NadjB/Hard_Bifrost/Docs/AD9851 DDS DAC Waveform Synthesizer/Carte de développement de générateur de Signal DDS AD9851.jpg

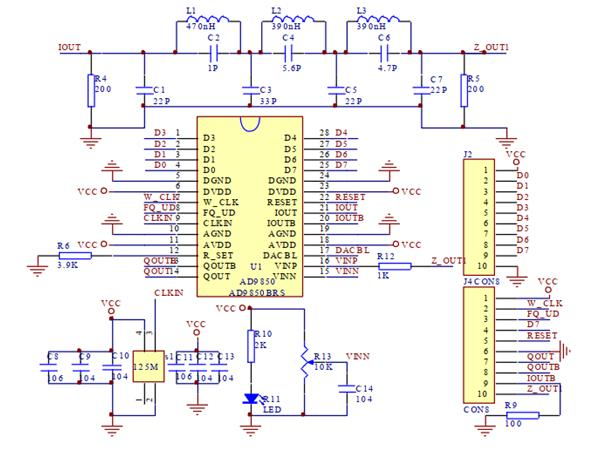
Docs/AD9851 DDS DAC Waveform Synthesizer/Carte de développement de générateur de Signal DDS AD9851.jpg
