NadjB/Hard_Bifrost/Docs/AD9851 DDS DAC Waveform Synthesizer/JOnYrMHFzqMlmSxvhkgJ.jpg

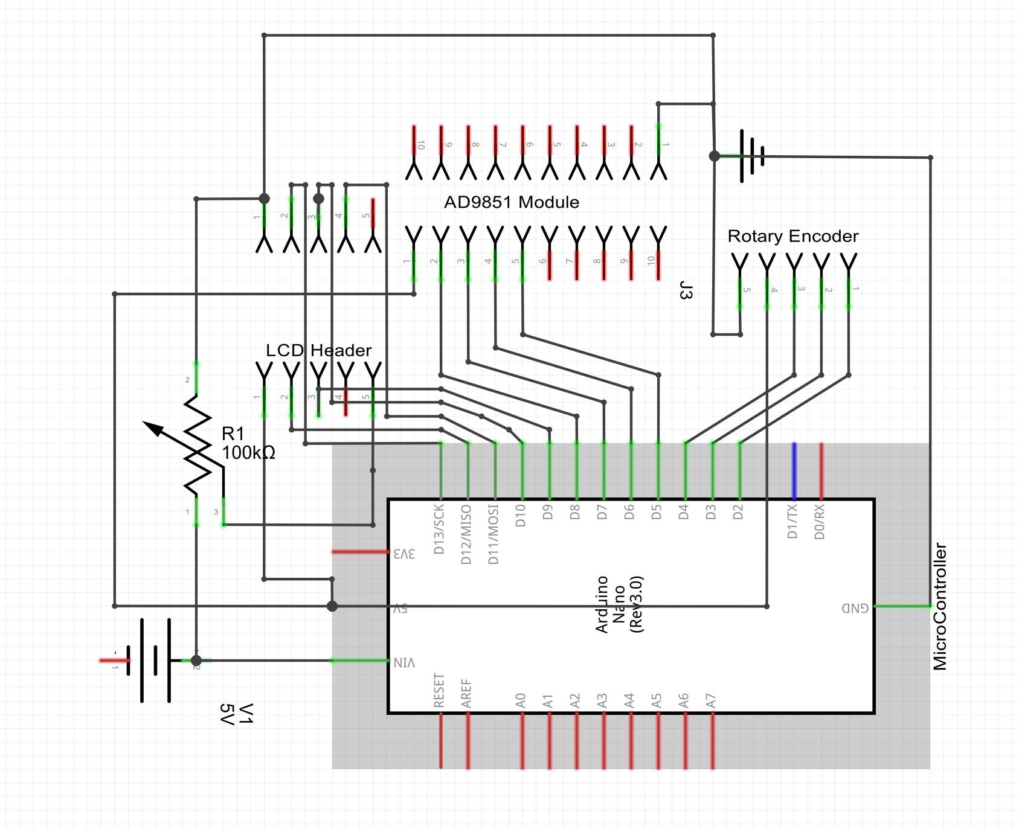
Docs/AD9851 DDS DAC Waveform Synthesizer/JOnYrMHFzqMlmSxvhkgJ.jpg
