NadjB/Hard_Bifrost/Bifrost.kicad_pcb

## KiCad design Bifrost.kicad_pcb (2023-07-12)

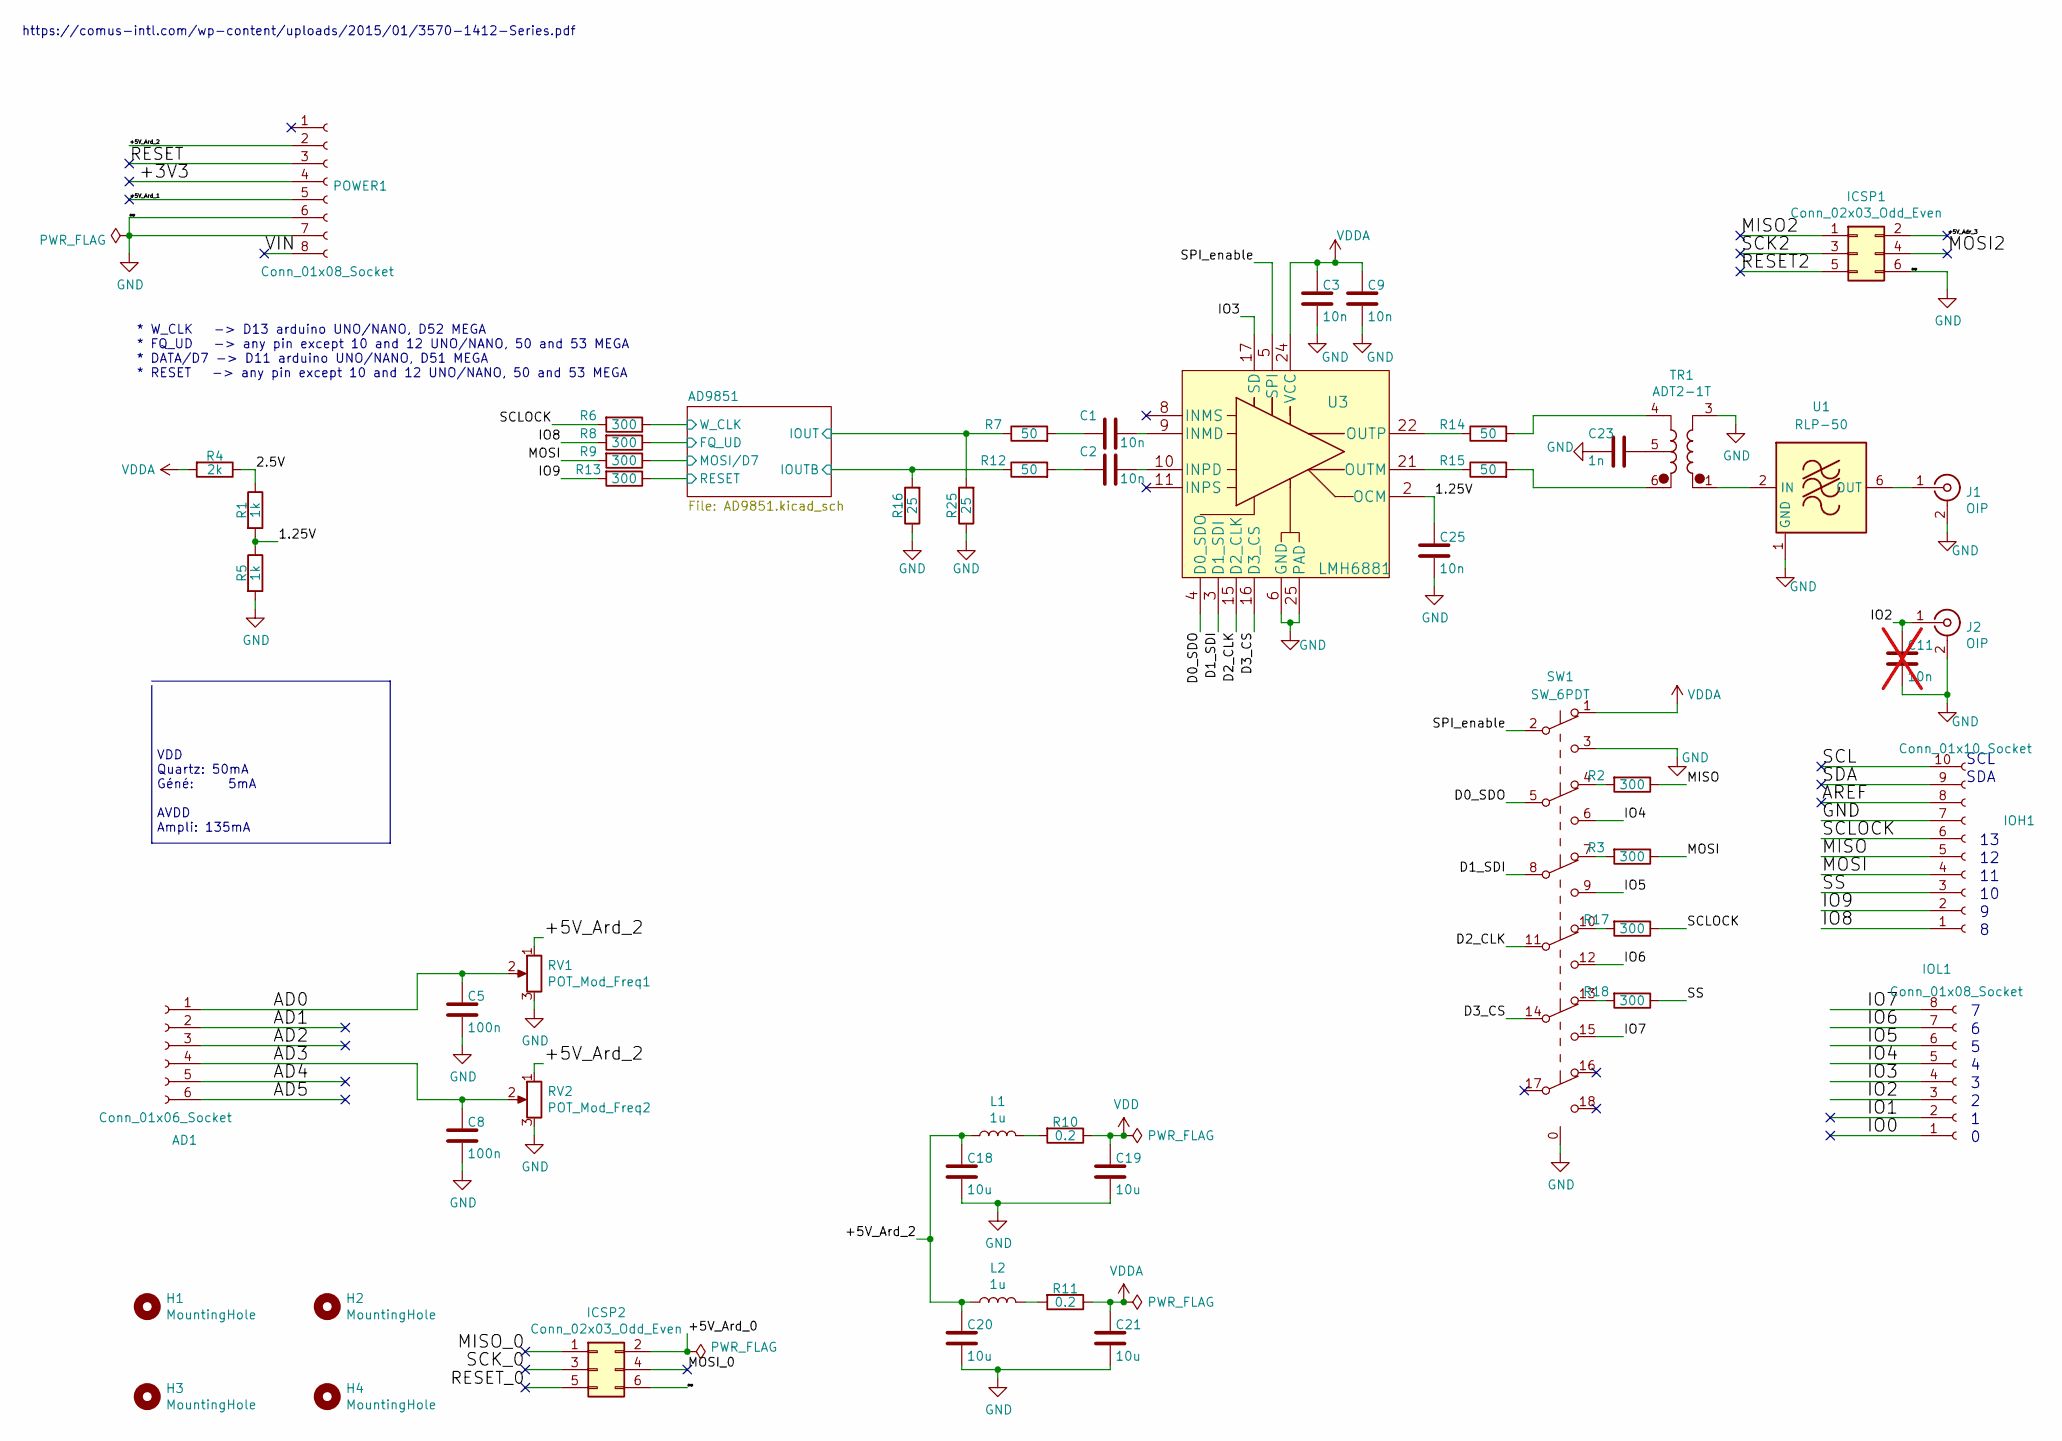
[picture p3: schematic Bifrost.kicad_sch]

Parts:
AD1: Conn_01x06_Socket; PinHeader_1x06_P2.54mm_Vertical
C1, C2, C3, C9, C25: 10n; C_0603_1608Metric_Pad1.08x0.95mm_HandSolder
C5, C8: 100n; C_0603_1608Metric_Pad1.08x0.95mm_HandSolder
C11: 10n; C_0603_1608Metric_Pad1.08x0.95mm_HandSolder; not fitted
C18, C19, C20, C21: 10u; C_1206_3216Metric_Pad1.33x1.80mm_HandSolder
C23: 1n; C_0603_1608Metric_Pad1.08x0.95mm_HandSolder
H1, H2, H3, H4: MountingHole; MountingHole_3mm
ICSP1, ICSP2: Conn_02x03_Odd_Even; PinSocket_2x03_P2.54mm_Vertical
IOH1: Conn_01x10_Socket; PinHeader_1x10_P2.54mm_Vertical
IOL1: Conn_01x08_Socket; PinHeader_1x08_P2.54mm_Vertical
J1, J2: OIP; SMA_Molex_73251-1153_EdgeMount_Horizontal
L1, L2: 1u; L_0603_1608Metric_Pad1.05x0.95mm_HandSolder
POWER1: Conn_01x08_Socket; PinHeader_1x08_P2.54mm_Vertical
R1, R5: 1k; R_0603_1608Metric_Pad0.98x0.95mm_HandSolder
R2, R3, R6, R8, R9, R13, R17, R18: 300; R_0603_1608Metric_Pad0.98x0.95mm_HandSolder
R4: 2k; R_0603_1608Metric_Pad0.98x0.95mm_HandSolder
R7, R12, R14, R15: 50; R_0603_1608Metric_Pad0.98x0.95mm_HandSolder
R10, R11: 0.2; R_0603_1608Metric_Pad0.98x0.95mm_HandSolder
R16, R25: 25; R_0603_1608Metric_Pad0.98x0.95mm_HandSolder
RV1: POT_Mod_Freq1; Potentiometer_Bourns_3266Y_Vertical
RV2: POT_Mod_Freq2; Potentiometer_Bourns_3266Y_Vertical
SW1: SW_6PDT; SW_EG6201
TR1: ADT2-1T; Mini-Circuits_CD542_H2.84mm
U1: RLP-50; Mini-Circuits_GP1212_LandPatternPL-176
U3: LMH6881; WQFN-24-1EP_4x4mm_P0.5mm_EP2.45x2.45mm_ThermalVias

Connections:
/1.25V: C25.2, R1.2, R5.1, U3.2 (OCM)
/2.5V: R1.1, R4.1
/+3V3: POWER1.4
/+5V_Adr_3: ICSP1.2
/+5V_Ard_0: ICSP2.2
/+5V_Ard_1: POWER1.5
/+5V_Ard_2: C18.2, C20.2, L1.1, L2.1, POWER1.2, RV1.1, RV2.1
/AD0: AD1.1, C5.2, RV1.2
/AD1: AD1.2
/AD2: AD1.3
/AD3: AD1.4, C8.2, RV2.2
/AD4: AD1.5
/AD5: AD1.6
/AD9851/FQ_UD: R8.1; also elsewhere on the board
/AD9851/IOUT: R7.1, R25.2; also elsewhere on the board
/AD9851/IOUTB: R12.1, R16.2; also elsewhere on the board
/AD9851/MOSI/D7: R9.1; also elsewhere on the board
/AD9851/RESET: R13.1; also elsewhere on the board
/AD9851/W_CLK: R6.1; also elsewhere on the board
/AREF: IOH1.8
/D0_SDO: SW1.5 (B), U3.4 (D0_SDO)
/D1_SDI: SW1.8 (B), U3.3 (D1_SDI)
/D2_CLK: SW1.11 (B), U3.15 (D2_CLK)
/D3_CS: SW1.14 (B), U3.16 (D3_CS)
/IO0: IOL1.1
/IO1: IOL1.2
/IO2: C11.2, IOL1.3, J2.1 (In)
/IO3: IOL1.4, U3.17 (SD)
/IO4: IOL1.5, SW1.6 (C)
/IO5: IOL1.6, SW1.9 (C)
/IO6: IOL1.7, SW1.12 (C)
/IO7: IOL1.8, SW1.15 (C)
/IO8: IOH1.1, R8.2
/IO9: IOH1.2, R13.2
/MISO: IOH1.5, R2.1
/MISO2: ICSP1.1
/MISO_0: ICSP2.1
/MOSI: IOH1.4, R3.1, R9.2
/MOSI2: ICSP1.4
/MOSI_0: ICSP2.4
/RESET: POWER1.3
/RESET2: ICSP1.5
/RESET_0: ICSP2.5
/SCK2: ICSP1.3
/SCK_0: ICSP2.3
/SCL: IOH1.10
/SCLOCK: IOH1.6, R6.2, R17.1
/SDA: IOH1.9
/SPI_enable: SW1.2 (B), U3.5 (SPI)
/SS: IOH1.3, R18.1
/VIN: POWER1.8
GND: C3.1, C5.1, C8.1, C9.1, C11.1, C18.1, C19.1, C20.1, C21.1, C23.1, C25.1, ICSP1.6, ICSP2.6, IOH1.7, J1.2 (Ext), J2.2 (Ext), POWER1.6, POWER1.7, R5.2, R16.1, R25.1, RV1.3, RV2.3, SW1.0, SW1.3 (C), TR1.3, U1.1 (GND), U1.3 (GND), U1.4 (GND), U1.5 (GND), U1.7 (GND), U1.8 (GND), U3.6 (GND), U3.7 (GND), U3.12 (GND), U3.13 (GND), U3.25 (PAD); also elsewhere on the board
unnamed: C1.1, R7.2
unnamed: C2.1, R12.2
unnamed: C23.2, TR1.5
unnamed: J1.1 (In), U1.6 (OUT)
unnamed: L1.2, R10.2
unnamed: L2.2, R11.2
unnamed: R2.2, SW1.4 (A)
unnamed: R3.2, SW1.7 (A)
unnamed: R14.2, TR1.4
unnamed: R15.2, TR1.6
unnamed: R17.2, SW1.10 (A)
unnamed: R18.2, SW1.13 (A)
unnamed: TR1.1, U1.2 (IN)
unnamed: C1.2, U3.9 (INMD)
unnamed: C2.2, U3.10 (INPD)
unnamed: R15.1, U3.21 (OUTM)
unnamed: R14.1, U3.22 (OUTP)
VDD: C19.2, R10.1; also elsewhere on the board
VDDA: C3.2, C9.2, C21.2, R4.2, R11.1, SW1.1 (A), U3.19 (VCC), U3.20 (VCC), U3.23 (VCC), U3.24 (VCC)

Notes on the sheet:
VDD Quartz: 50mA Géné: 5mA AVDD Ampli: 135mA
SDA
https://comus-intl.com/wp-content/uploads/2015/01/3570-1412-Series.pdf
* W_CLK -> D13 arduino UNO/NANO, D52 MEGA * FQ_UD -> any pin except 10 and 12 UNO/NANO, 50 and 53 MEGA * DATA/D7 -> D11 arduino UNO/NANO, D51 MEGA * RESET -> any pin except 10 and 12 UNO/NANO, 50 and 53 MEGA
SCL

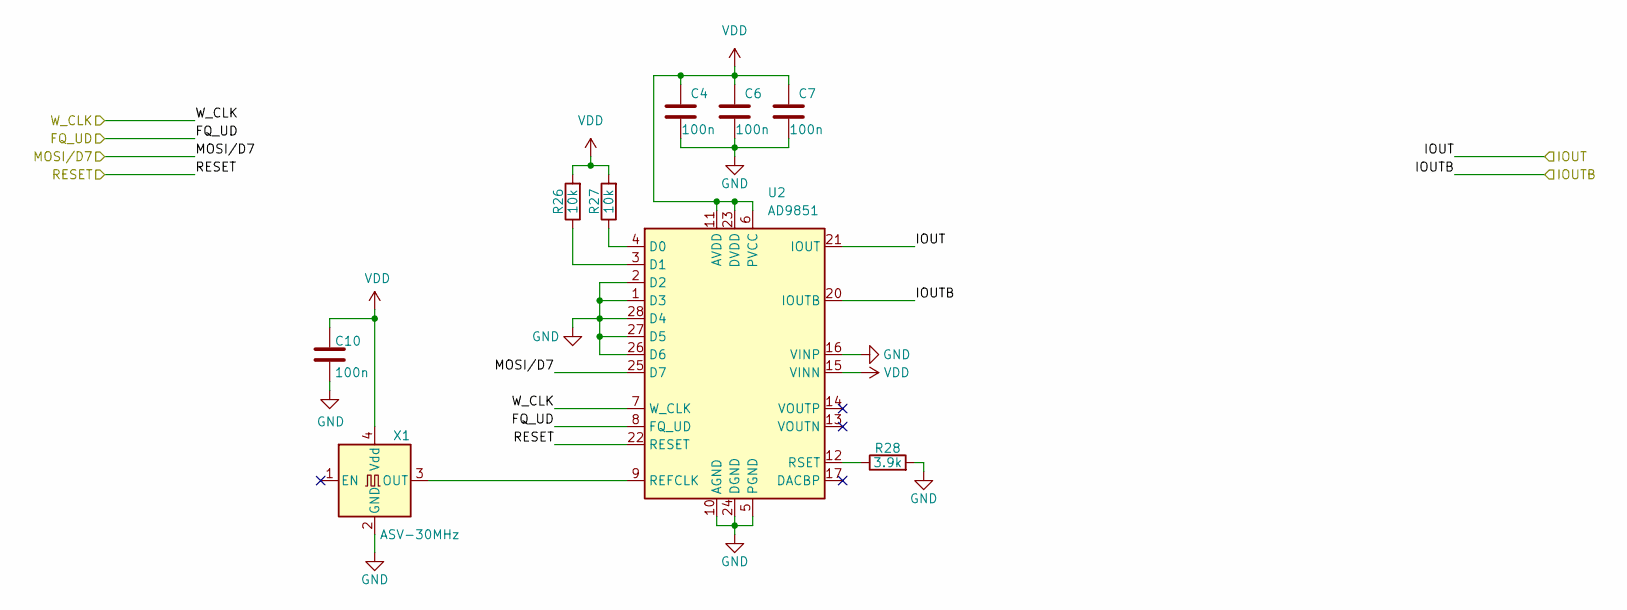
[picture p4: schematic AD9851.kicad_sch]

Parts:
C4, C6, C7, C10: 100n; C_0603_1608Metric_Pad1.08x0.95mm_HandSolder
R26, R27: 10k; R_0603_1608Metric_Pad0.98x0.95mm_HandSolder
R28: 3.9k; R_0603_1608Metric_Pad0.98x0.95mm_HandSolder
U2: AD9851; SSOP-28_5.3x10.2mm_P0.65mm
X1: ASV-30MHz; Oscillator_SMD_Abracon_ASV-4Pin_7.0x5.1mm

Connections:
/AD9851/FQ_UD: U2.8 (FQ_UD); also elsewhere on the board
/AD9851/IOUT: U2.21 (IOUT); also elsewhere on the board
/AD9851/IOUTB: U2.20 (IOUTB); also elsewhere on the board
/AD9851/MOSI/D7: U2.25 (D7); also elsewhere on the board
/AD9851/RESET: U2.22 (RESET); also elsewhere on the board
/AD9851/W_CLK: U2.7 (W_CLK); also elsewhere on the board
GND: C4.2, C6.2, C7.2, C10.1, R28.2, U2.1 (D3), U2.2 (D2), U2.5 (PGND), U2.10 (AGND), U2.16 (VINP), U2.19 (AGND), U2.24 (DGND), U2.26 (D6), U2.27 (D5), U2.28 (D4), X1.2 (GND); also elsewhere on the board
unnamed: R27.1, U2.4 (D0)
unnamed: R26.1, U2.3 (D1)
unnamed: U2.9 (REFCLK), X1.3 (OUT)
unnamed: R28.1, U2.12 (RSET)
VDD: C4.1, C6.1, C7.1, C10.2, R26.2, R27.2, U2.6 (PVCC), U2.11 (AVDD), U2.15 (VINN), U2.18 (AVDD), U2.23 (DVDD), X1.4 (Vdd); also elsewhere on the board

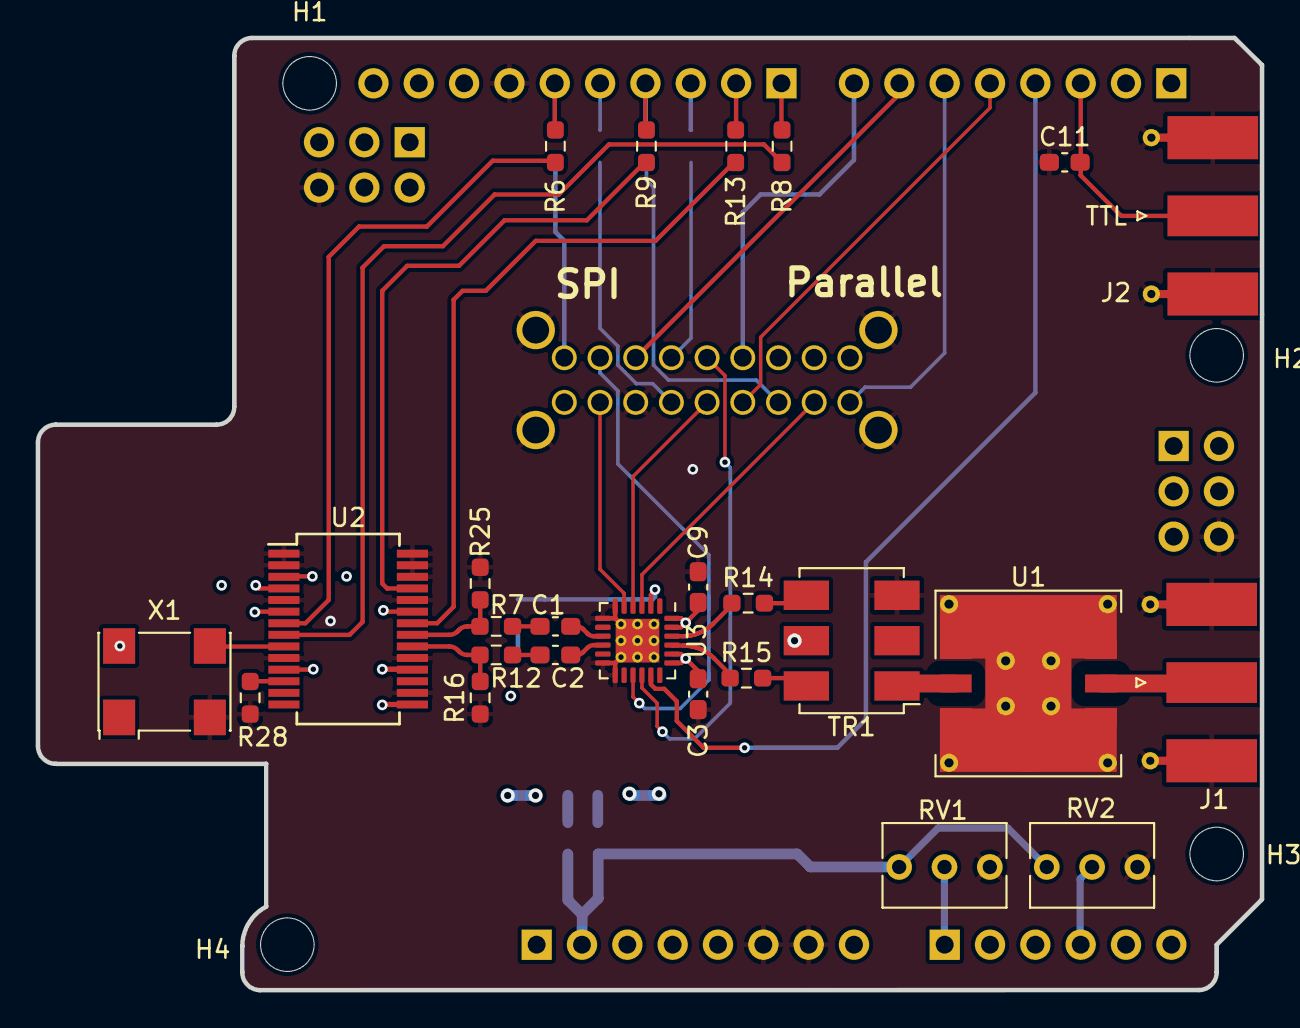
[picture p5: board Bifrost.kicad_pcb from above]

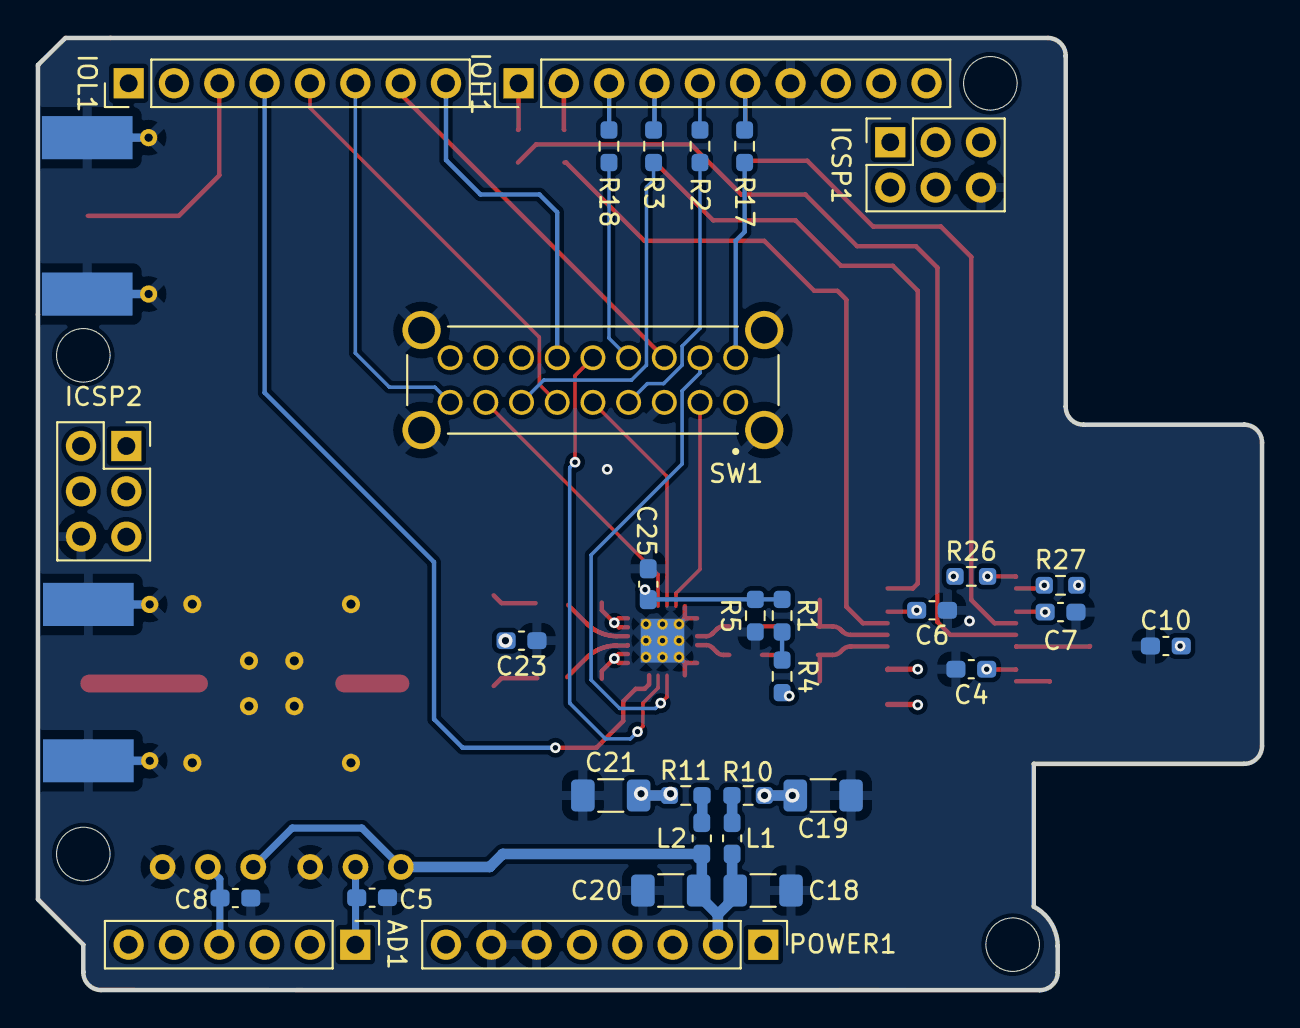
[picture p6: board Bifrost.kicad_pcb from below]

Board: 4 copper layers, 68.6 x 53.3 mm, 61 parts (32 on the bottom side), 52 nets.
