NadjB/Hard_Bifrost/(commit log)

2021-07-01 Made the HMC900 single ended in/out
    [AlimHMC860.sch, Bifrost.kicad_pcb, Bifrost.sch, HMC900.sch, Input_HMC900.sch, Output_HMC900.sch]
2021-07-20 Corrected errors from single ended transition
    [Bifrost.sch, HMC900.sch, Input_HMC900.sch, Output_HMC900.sch]
2021-07-20 deleted superfluous components and began routing
    [Bifrost.kicad_pcb]
2021-07-20 passage 0402 => 0603
    [AlimHMC860.sch, Bifrost.kicad_pcb, Bifrost.sch, HMC900.sch, Input_HMC900.sch, Output_HMC900.sch]
2021-07-20 Changed power connector to barrel jack and Cal connector to pinhead
    [Bifrost.sch, Output_HMC900.sch]
2021-07-20 Changed transfo reference from gnd to 2.5v because ds1085 goes from 0 to 5v
    [Bifrost.kicad_pcb, Input_HMC900.sch]
2021-07-20 Made it so there was only one output and change the SMA (to a sourceable one)
    [Bifrost.kicad_pcb, Bifrost.sch, Input_HMC900.sch, Output_HMC900.sch]
2021-07-21 Corrected SDA & SCL Pins progressed the routing
    [Bifrost.kicad_pcb, Bifrost.sch]
2021-07-21 Changed input transformer reference to 2.5v
    [Bifrost.kicad_pcb, Input_HMC900.sch, Output_HMC900.sch]
2021-07-21 Straitened things before restarting routing
    [Bifrost.kicad_pcb, Bifrost.sch, Input_HMC900.sch, Output_HMC900.sch]
2021-07-22 v0 Routing done
    [AlimHMC860.sch, Bifrost.kicad_pcb, Bifrost.sch, Output_HMC900.sch]
2021-07-22 Rounded tracks
    [Bifrost.kicad_pcb]
2021-07-26 Via fencing
    [Bifrost.kicad_pcb]
2021-07-29 Added BPF-E16+
    [Bifrost.sch]
2021-07-29 Added soldering options
    [Bifrost.sch]
2021-07-29 Added Logic gate buffer for the oscillator
    [Bifrost.kicad_pcb, Bifrost.sch, Input_HMC900.sch]
2021-07-29 Added filtering capa and rearanged analogue in (A1=>A4)
    [Bifrost.sch]
2021-07-29 Added options for the tranfo
    [Bifrost.kicad_pcb, Input_HMC900.sch, Output_HMC900.sch]
2021-07-30 reorganized to match power consumption
    [AlimHMC860.sch]
2021-07-30 added cavalier on the oscillator's power
    [Bifrost.kicad_pcb, Bifrost.sch, Input_HMC900.sch, Output_HMC900.sch]
2021-07-30 Connected the oscillators enable to the arduino
    [Bifrost.kicad_pcb, Bifrost.sch]
2021-08-03 added the option to switch HMC860 for HMC1060
    [AlimHMC860.sch, Bifrost.kicad_pcb, Bifrost.sch, Output_HMC900.sch]
2021-08-04 Added capacitors on potars
    [Bifrost.kicad_pcb, Bifrost.sch]
2021-08-05 Rearranged the serigraphs
    [Bifrost.kicad_pcb]
2021-08-06 Bifrost_v1.0 launched to fab
    [Bifrost.kicad_pcb]
2021-08-27 As implemented for v1
    [Bifrost.sch, Input_HMC900.sch, Output_HMC900.sch]
2021-08-27 removed unused options added aop at the output
    [Bifrost.sch, Input_HMC900.sch, Output_HMC900.sch]
2021-08-30 output tranfo and aop work around vdd/2 caped aop's amplification at 9dB
    [Bifrost.sch, Output_HMC900.sch]
2021-09-06 switched to "AD5932" from "ds1085 & hmc900" Removed external power supply
    [AlimHMC860.sch, Bifrost.sch]
2021-09-10 Changed the pins ad5932<==>arduino to avoide Rx & Tx
    [Bifrost.sch]
2021-09-13 added a second ad5932
    [Bifrost.sch]
2021-09-15 Made a AVDD and DVDD Put an offset on the output off the signal generator
    [Bifrost.sch]
2021-09-16 Added fixed gain amplifiers Tweaked the filtering of AVDD & DVDD Began placing componants Put in feuille hierarchique
    [Bifrost.kicad_pcb, Bifrost.sch]
2021-09-16 addendum feuille hierarchique
    [AD5932.sch]
2021-09-17 Progressed in placement
    [Bifrost.kicad_pcb]
2021-09-21 Implemented the LMH6881 instead of the AD8000 Continued routing
    [AD5932.sch, Bifrost.kicad_pcb, Bifrost.sch]
2021-09-28 Deleted the fix gain amlifier
    [AD5932.sch, Bifrost.kicad_pcb]
2021-09-28 put the AD5932's Standby to the ground
    [Bifrost.sch]
2021-10-06 Changed gain pins for the LMH6881 and changed alim for the oscillator
    [Bifrost.kicad_pcb, Bifrost.sch]
2021-10-07 Changed inductor and reststor on power filtration to limit DDP
    [AD5932.sch, Bifrost.sch]
2021-10-07 v1.0 of the routing
    [Bifrost.kicad_pcb]
2021-10-13 Position des jumper/switch
    [Bifrost.kicad_pcb]
2021-11-02 Optimized routing
    [Bifrost.kicad_pcb]
2021-11-03 Added thermal vias for the LMH6881 and re-routed to accommodate
    [Bifrost.kicad_pcb]
2021-11-03 Same as the last part 2
    [Bifrost.kicad_pcb, Bifrost.sch]
2021-11-08 Bifrost_v2.0 launched to fab Modified LMH6881's thermal vias Rotated GND pads to better propagate GND
    [Bifrost.kicad_pcb]
2021-11-16 Added notes to switch the position off the switches and renamed doc
    [Bifrost.sch]
2021-12-01 Began implementing AD9851
    [AD5932.sch, Bifrost.sch]
2022-03-03 Switched to KiCad 6 Replaced AD5932 by AD9851 Moved amplifier switches to D0&D3
    [AD5932.kicad_sch, AD9851.kicad_sch, Bifrost.kicad_sch]
2022-03-07 Added filters on output wired the option to have all of the amplifier parallel bits connected
    [AD9851.kicad_sch, Bifrost.kicad_pcb, Bifrost.kicad_sch]
2022-03-08 Done routing and serigraphie
    [Bifrost.kicad_pcb]
2022-03-09 Finished serigraphie IBOM generated and components sourced
    [Bifrost.kicad_pcb, Bifrost.kicad_sch]
2022-03-09 removed .kicad_prl
2022-04-27 As implemented
    [Bifrost.kicad_sch]
2022-05-04 Connected ampli's ShutDown pin
    [Bifrost.kicad_pcb, Bifrost.kicad_sch]
2023-06-02 Switched to Kicad 7
    [AD9851.kicad_sch, Bifrost.kicad_pcb, Bifrost.kicad_sch]
2023-06-02 Replaced SPI selection resistors with a 6PDT (LMH6881 pins 3, 4, 5, 15, 16)
    [Bifrost.kicad_sch]
2023-06-12 Implemented change on pcb Updated Schematics symbols to Kicad 7 standards (Female=>Socket...)
    [AD9851.kicad_sch, Bifrost.kicad_pcb, Bifrost.kicad_sch]
2023-06-12 Added TTL output
    [Bifrost.kicad_pcb, Bifrost.kicad_sch]
2023-07-12 As impemented v2
    [Bifrost.kicad_pcb, Bifrost.kicad_sch]
